nhacai-ns/rf-rtk-system/Documents/Base_Description.jpg

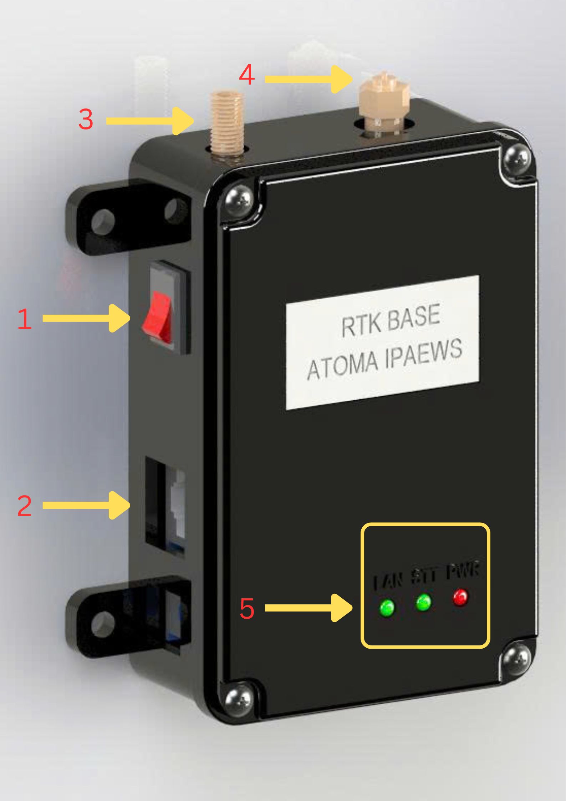
Documents/Base_Description.jpg
