nhacai-ns/rf-rtk-system/Documents/Base.jpg

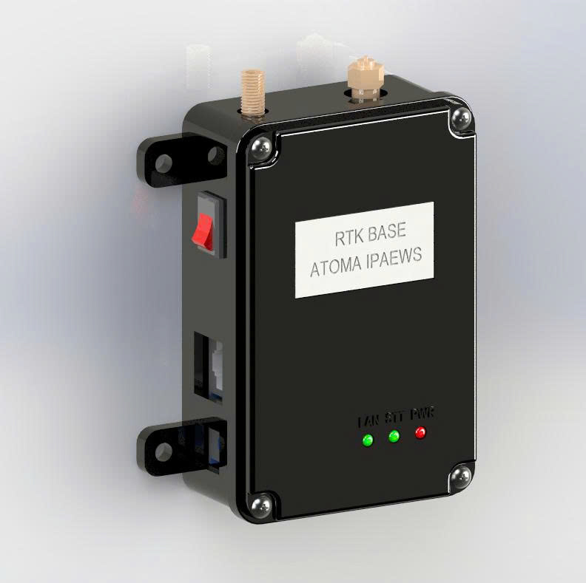
Documents/Base.jpg
