nhacai-ns/rf-rtk-system/Documents/Base setup.txt

freset
// mode base time 120 1 2

// Base 1
MODE BASE 16.0392998525, 108.2408618000 12
MODE BASE 16.0392920731, 108.2408451177 12

// base 2	
MODE BASE 16.0398408467, 108.2404718993 9

//MODE BASE 16.097088 108.076337 19
//gngga 1

//CONFIG SIGNALGROUP 2
RTCM1006 COM1 5
RTCM1033 COM1 5
RTCM1074 COM1 1
RTCM1084 COM1 1
RTCM1094 COM1 1
//RTCM1114 COM1 1
RTCM1124 COM1 1
saveconfig
?>:
RTCM1077 COM1 1
RTCM1087 COM1 1
RTCM1097 COM1 1
RTCM1127 COM1 1
