nhacai-ns/rf-rtk-system/Documents/Rover setup.txt

freset
mode rover
gngga 1
//gngsv 1
//gngsa 1
//gpgst 1
//gnrmc 1
saveconfig
