nhacai-ns/rf-rtk-system/Main/location_test.txt

góc 1: 16.039828544533634, 108.24049751343361
góc 2: 16.039903300434982, 108.24064972878959
góc 3: 16.039726077345534, 108.24055719257888
