nhacai-ns/rf-rtk-system/Documents/Base UM980.pdf

### +3V3_Ethernet

GND | GND

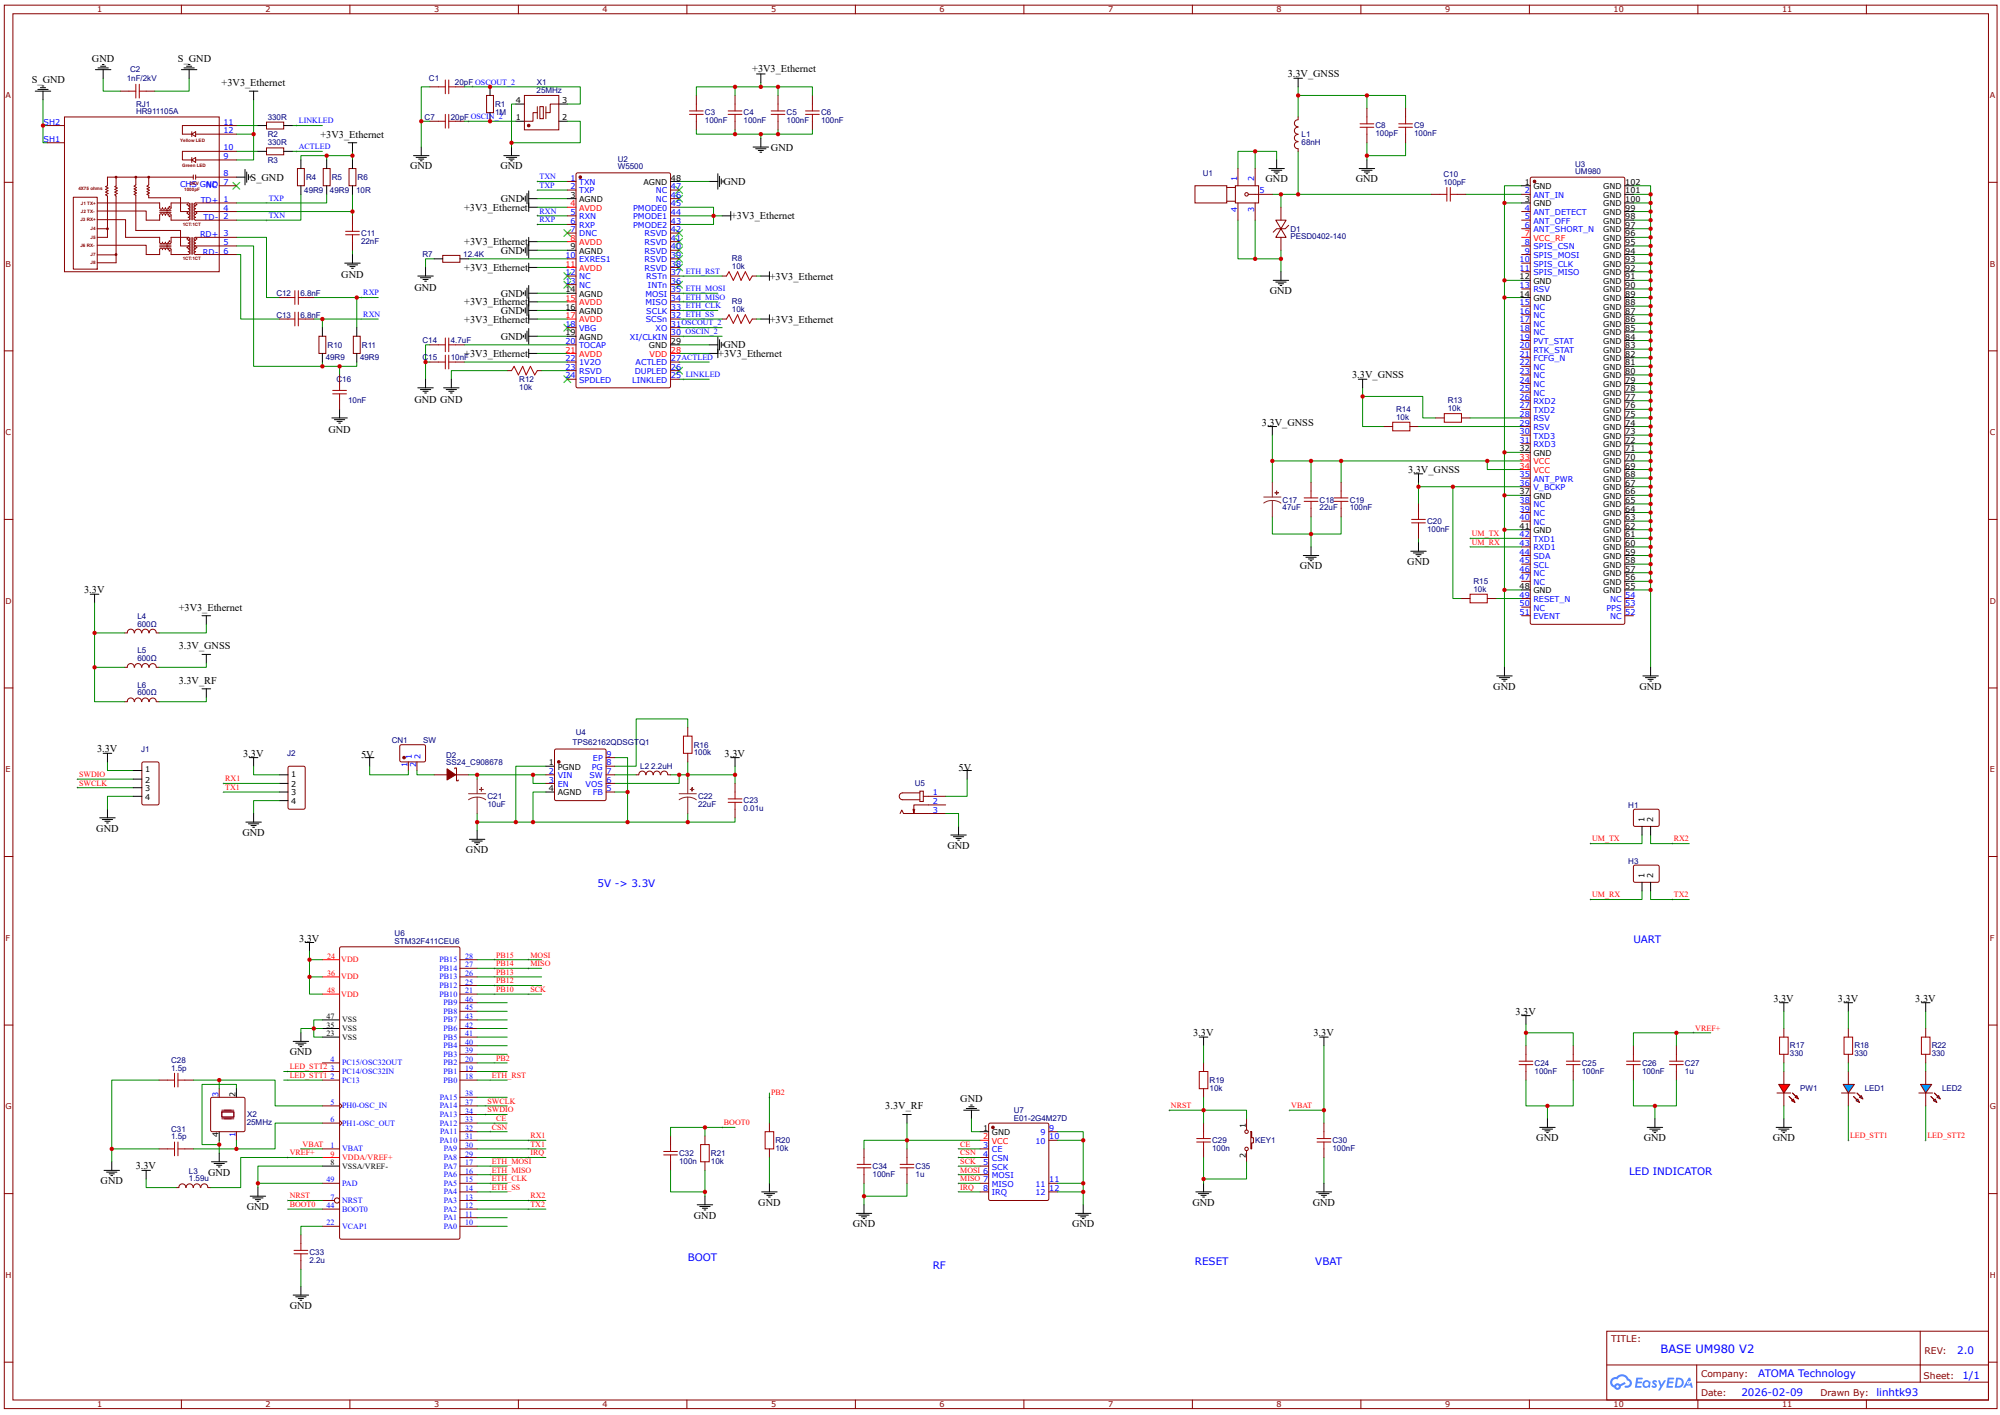
[picture p7: page 1]
