nhacai-ns/rf-rtk-system/Documents/Rover UM980.pdf

3.3V

### GND

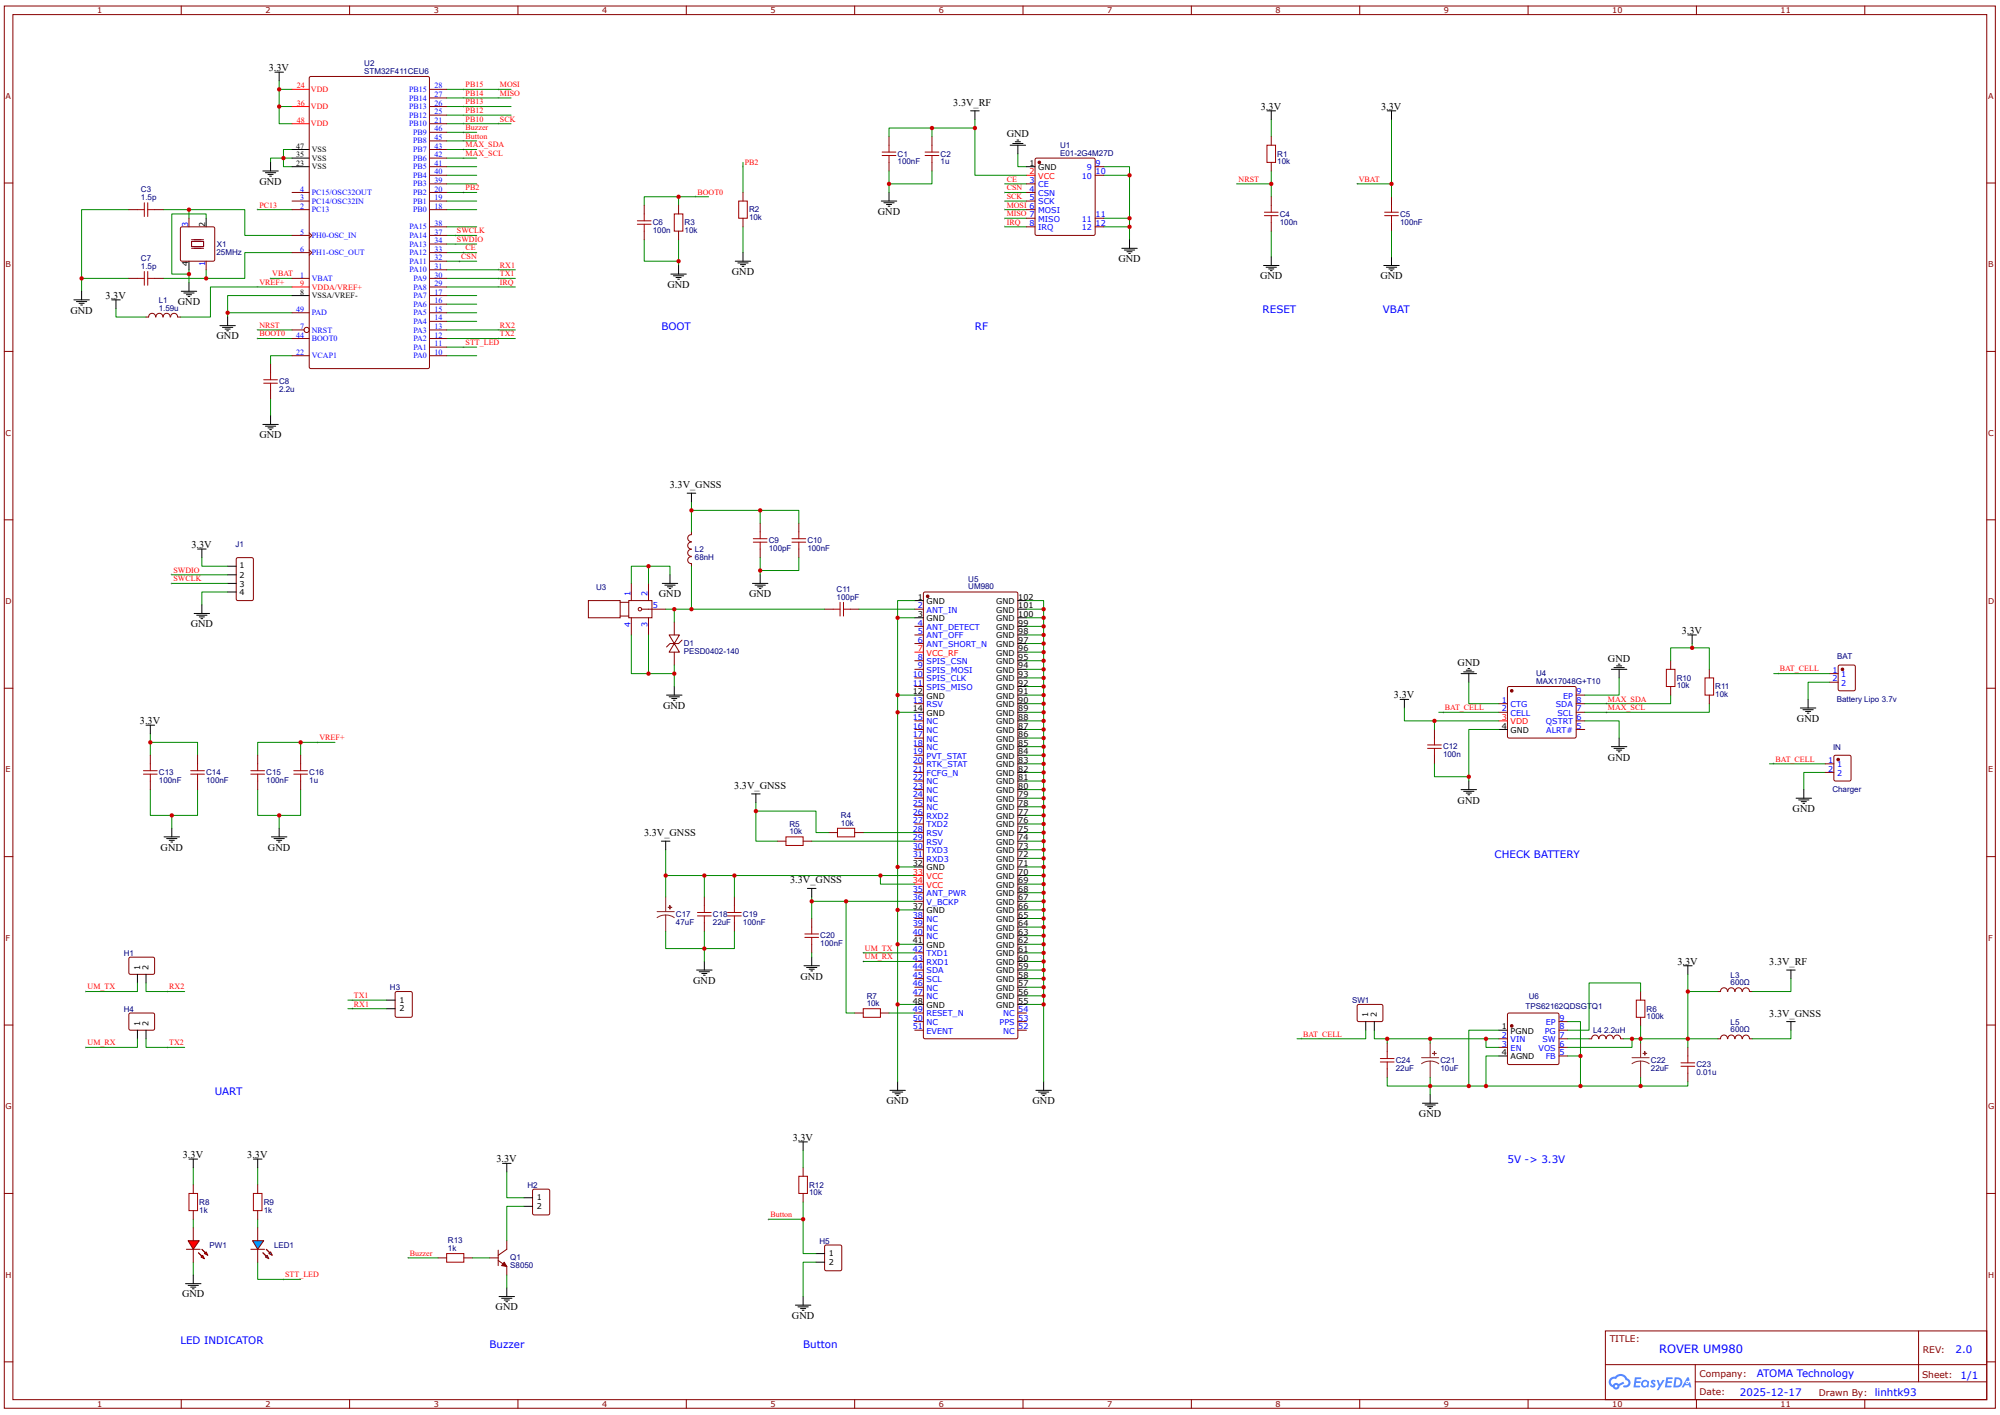
[picture p8: page 1]
