nhacai-ns/rf-rtk-system/(commit log)

2026-04-13 fear: beep when low pin and
2026-04-15 fix: add mask irq, soc > 100, clean code
    [Base.ino, Rover.ino, configs.h, uart_dma.cpp]
2026-04-18 fix: rf watch dog timer
    [Base.ino, Repeater.ino, Rover.ino, configs.h]
2026-04-22 fix: avoid repeater echoing, add (all level) automatic mechanism reseting
    [Base.ino, Repeater.ino, configs.h]
